rotep/scissorball/docs/images/render_left.png

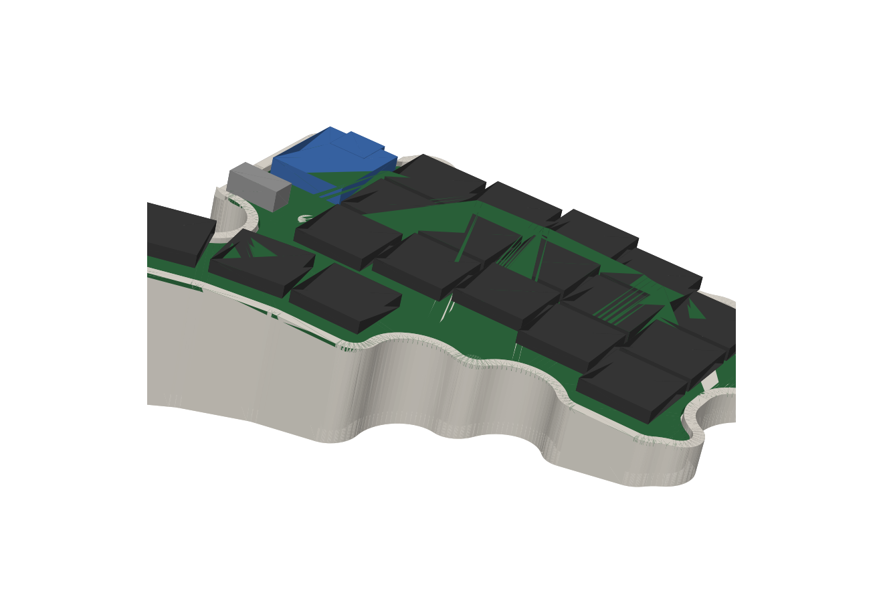
docs/images/render_left.png
