rotep/scissorball/docs/images/render_right.png

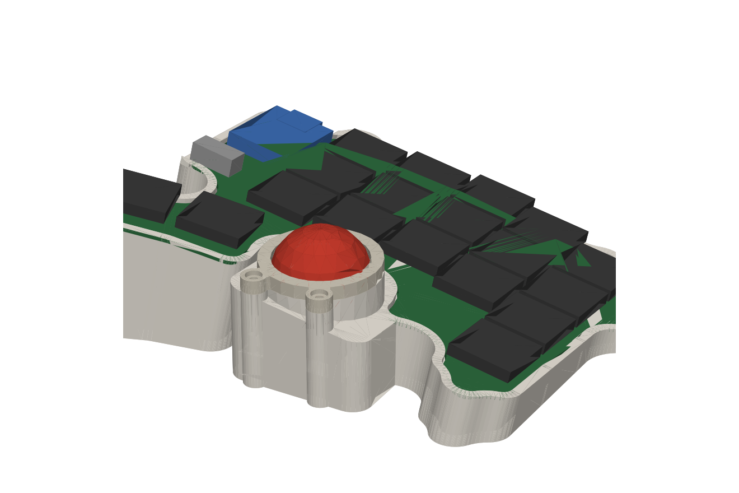
docs/images/render_right.png
