rotep/scissorball/docs/images/render_right_case_only.png

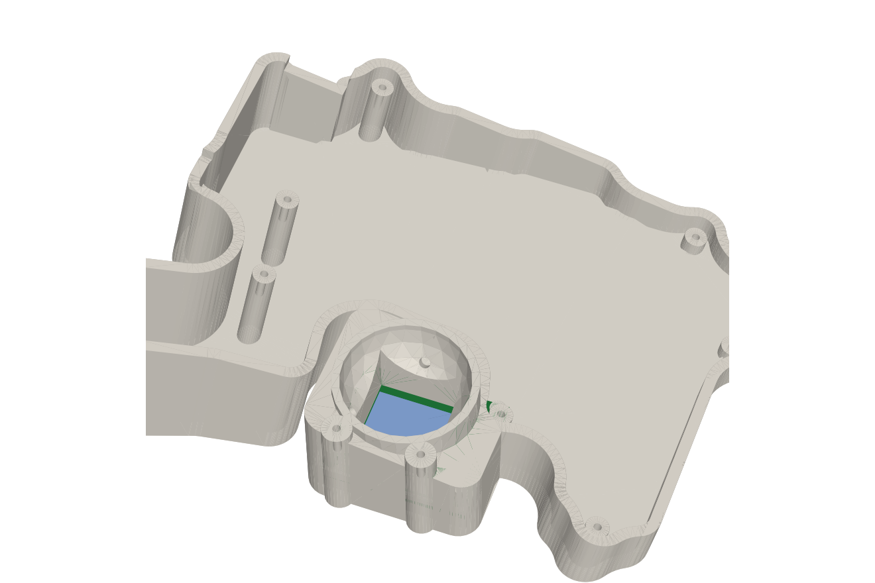
docs/images/render_right_case_only.png
