rotep/scissorball/hardware/case/scissorball_case_right.step

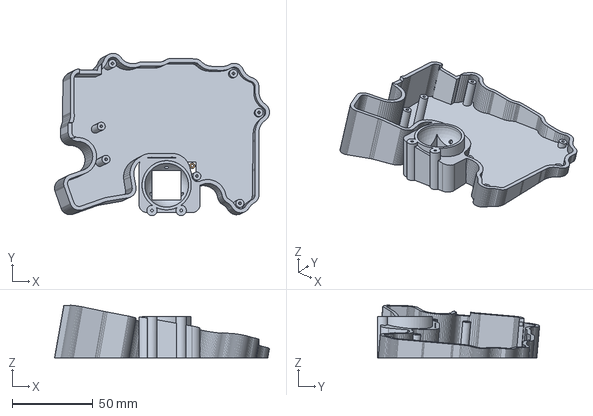
[picture p8: CAD file, 2026-09-30]
hardware/case/scissorball_case_right.step
132.9 x 100.3 x 32.5 mm
