rotep/scissorball/hardware/pcb/left/scissorball_left_pcb.step

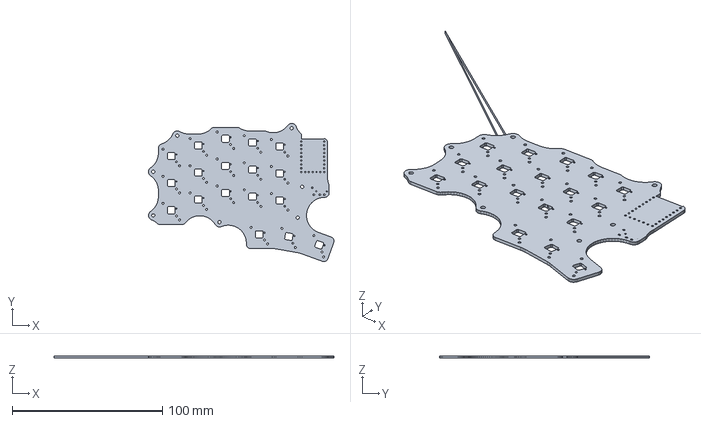
[picture p9: CAD file, 2026-09-30]
hardware/pcb/left/scissorball_left_pcb.step
186.2 x 139.7 x 1.51 mm
