rotep/scissorball/hardware/pcb/right/scissorball_right_pcb.step

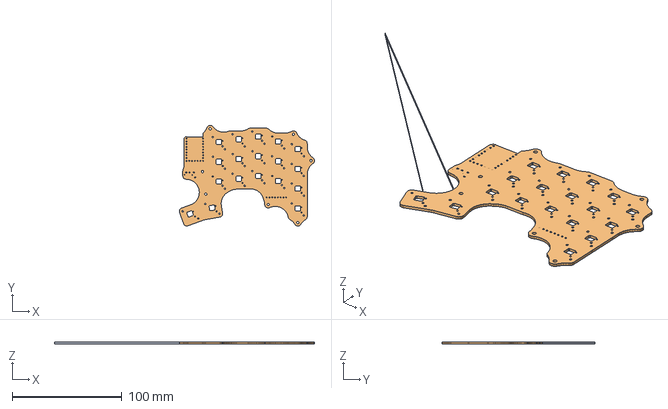
[picture p10: CAD file, 2026-09-30]
hardware/pcb/right/scissorball_right_pcb.step
237.2 x 139.7 x 1.51 mm
