rotep/scissorball/hardware/case/scissorball_case_left.step

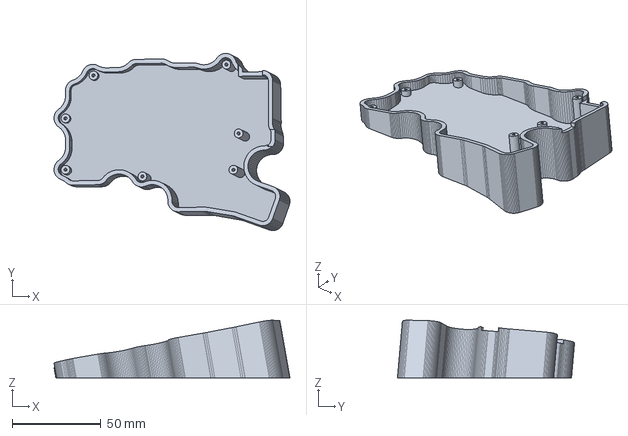
[picture p11: CAD file, 2026-09-30]
hardware/case/scissorball_case_left.step
132.9 x 99.7 x 32.5 mm
