rotep/scissorball/hardware/case/scissorball_ball_bezel.step

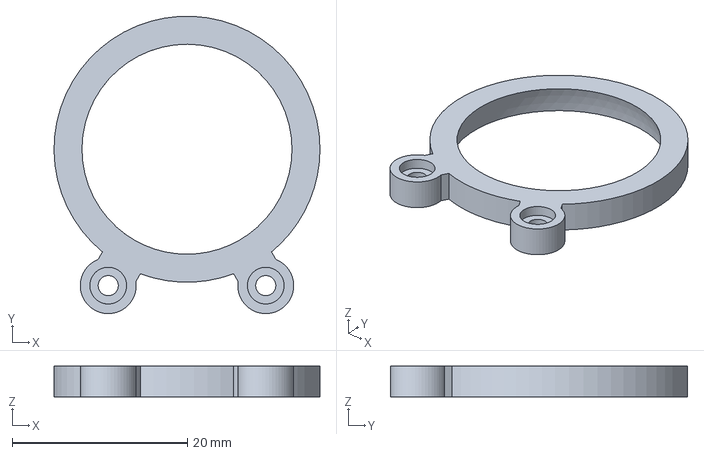
[picture p12: CAD file, 2026-09-30]
hardware/case/scissorball_ball_bezel.step
30.4 x 34.0 x 3.50 mm
