rotep/scissorball/(list of files, cad)

Other CAD files:
hardware/case/scissorball_ball_bezel.3mf
hardware/case/scissorball_ball_bezel.stl
hardware/case/scissorball_case_left.3mf
hardware/case/scissorball_case_left.stl
hardware/case/scissorball_case_right.3mf
hardware/case/scissorball_case_right.stl
