rotep/scissorball/docs/layout_1to1.pdf

ScissorBall 36 1:1 layout (A4 landscape, 100% / | )

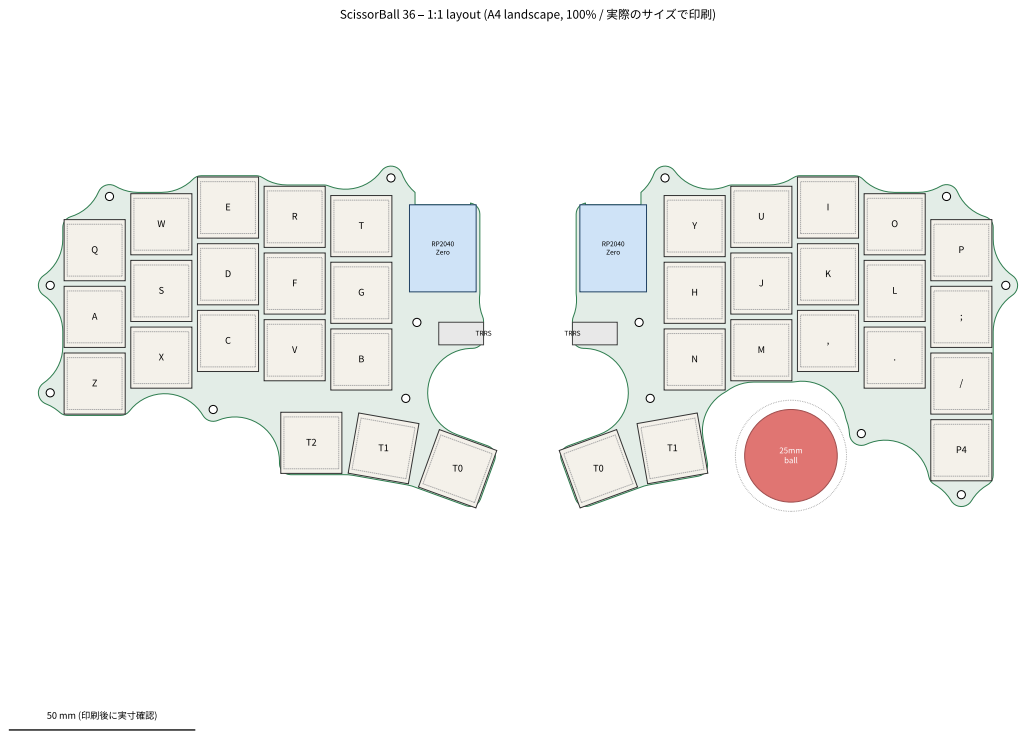
[picture p13: page 1]
RP2040 Zero; TRRS; ball
