rotep/scissorball/docs/pcb_left_1to1.pdf

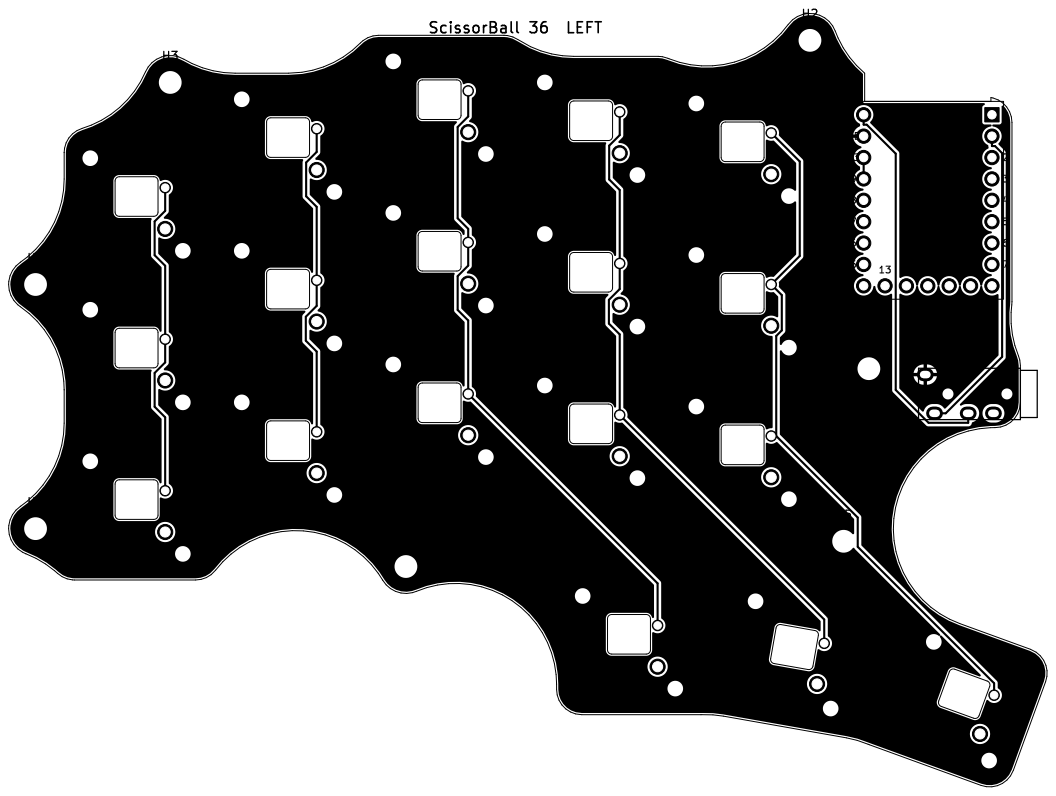
[picture p14: page 1]
