rotep/scissorball/docs/pcb_right_1to1.pdf

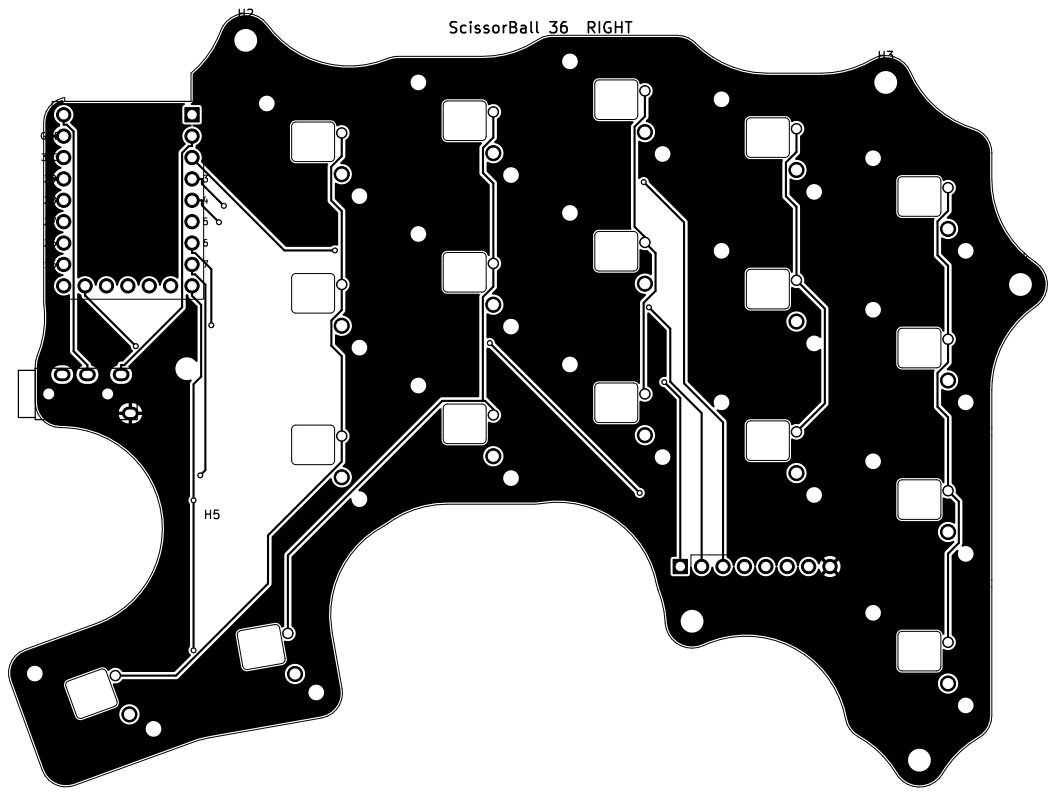
[picture p15: page 1]
