rotep/scissorball/hardware/pcb/right/scissorball_right.kicad_pcb

## KiCad design hardware/pcb/right/scissorball_right.kicad_pcb (2026-09-30)

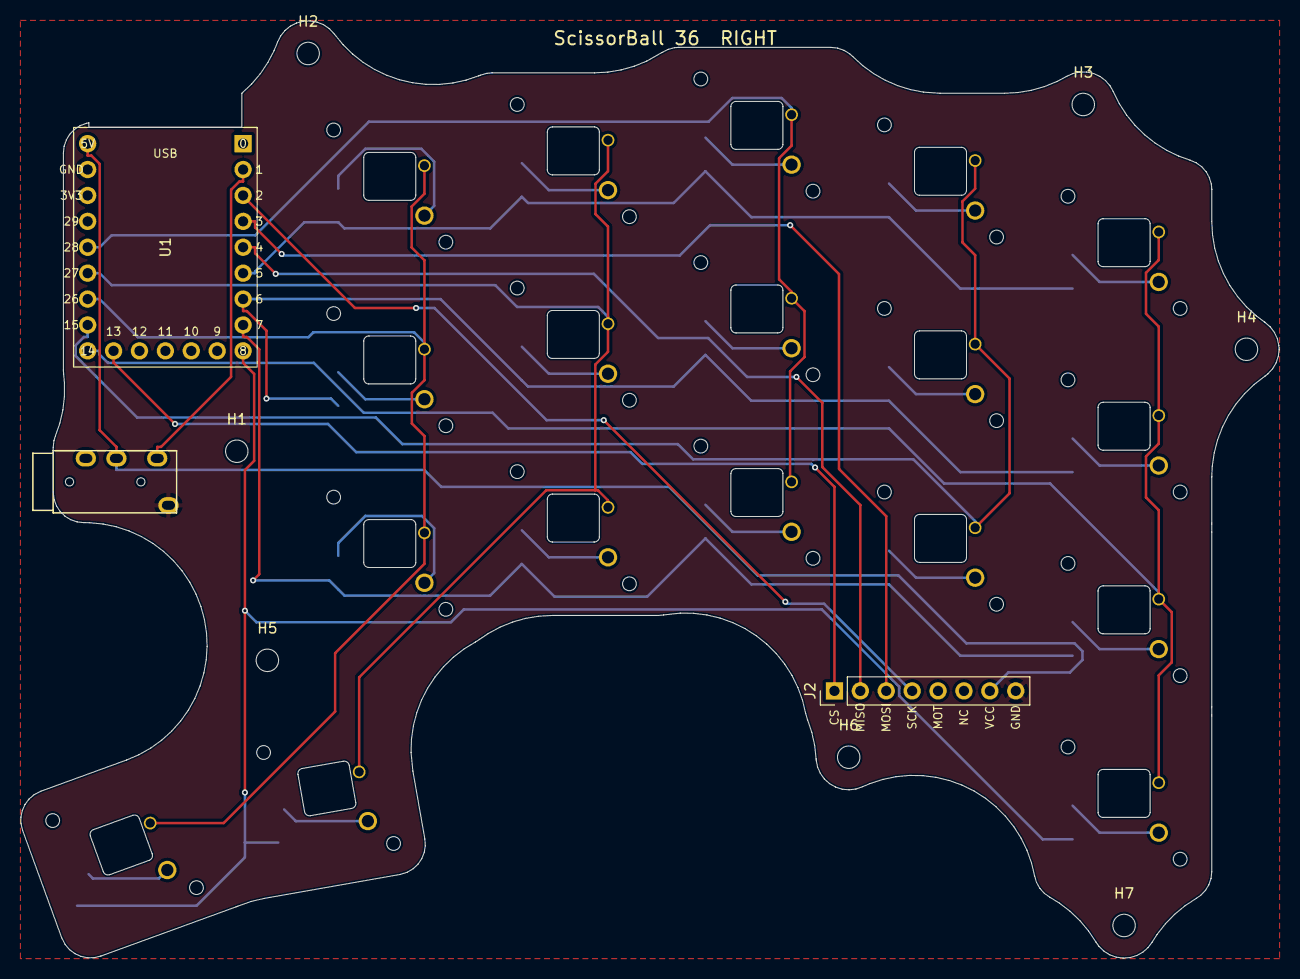
[picture p16: board scissorball_right.kicad_pcb from above]

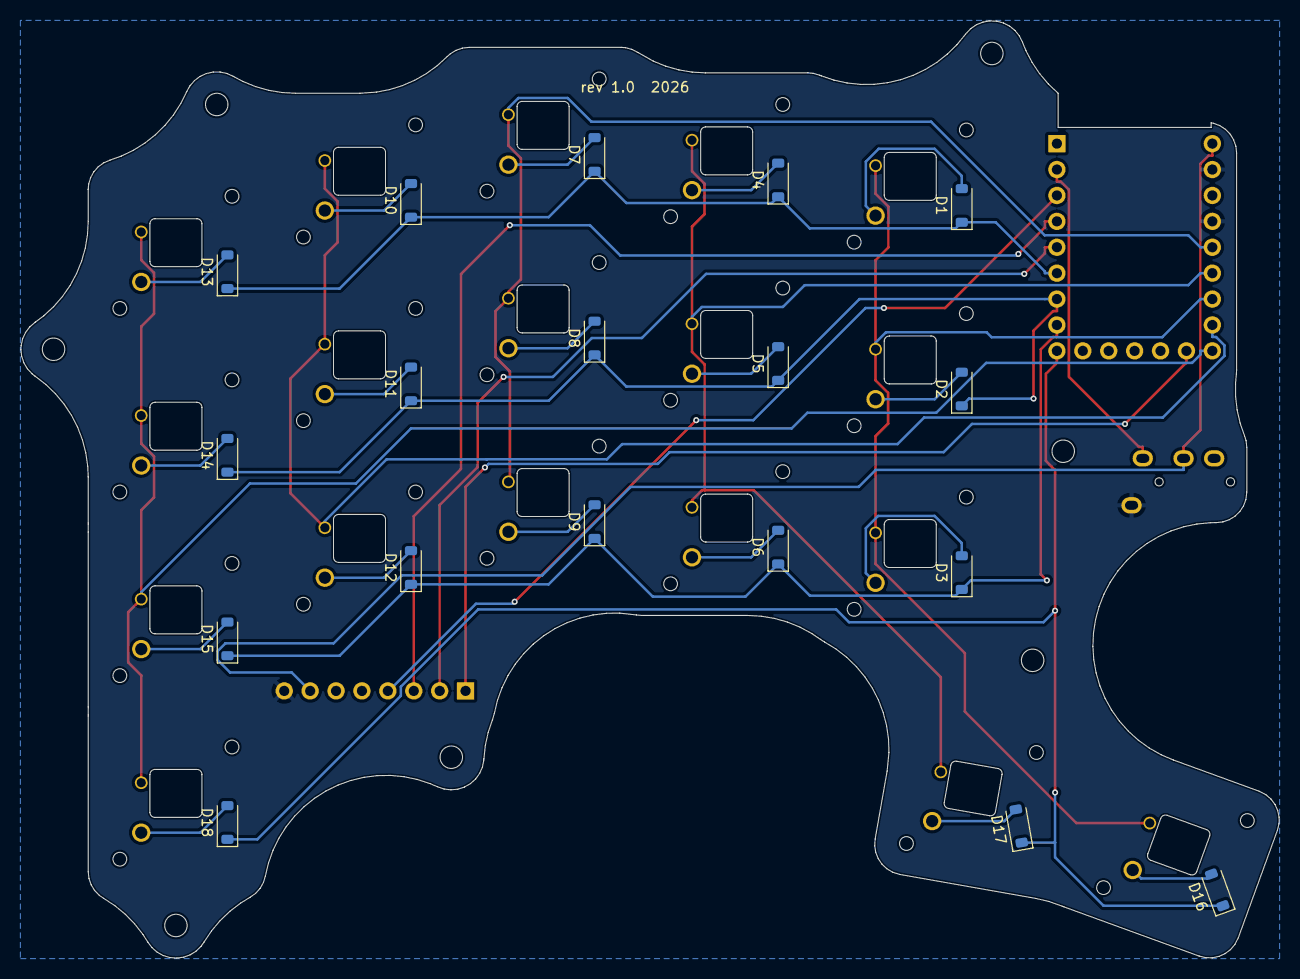
[picture p17: board scissorball_right.kicad_pcb from below]

Board: 2 copper layers, 123.4 x 91.9 mm, 46 parts (18 on the bottom side), 34 nets.

Parts:
D1, D2, D3, D4, D5, D6, D7, D8, D9, D10, D11, D12, D13, D14, D15, D16, D17, D18: 1N4148W; D_SOD-123
H1, H2, H3, H4, H5, H6, H7: MountingHole_2.2mm_M2
J1: PJ-320A; SB_TRRS_PJ-320A
J2: PMW3360 breakout; PinHeader_1x08_P2.54mm_Vertical
SW1: K00; SB_Kailh_PG1425
SW2: K10; SB_Kailh_PG1425
SW3: K20; SB_Kailh_PG1425
SW4: K01; SB_Kailh_PG1425
SW5: K11; SB_Kailh_PG1425
SW6: K21; SB_Kailh_PG1425
SW7: K02; SB_Kailh_PG1425
SW8: K12; SB_Kailh_PG1425
SW9: K22; SB_Kailh_PG1425
SW10: K03; SB_Kailh_PG1425
SW11: K13; SB_Kailh_PG1425
SW12: K23; SB_Kailh_PG1425
SW13: K04; SB_Kailh_PG1425
SW14: K14; SB_Kailh_PG1425
SW15: K24; SB_Kailh_PG1425
SW16: T0; SB_Kailh_PG1425
SW17: T1; SB_Kailh_PG1425
SW18: P4; SB_Kailh_PG1425
U1: RP2040-Zero; SB_RP2040_Zero

Connections:
COL0: SW1.1, SW2.1, SW3.1, SW16.1, U1.GP26
COL1: SW4.1, SW5.1, SW6.1, SW17.1, U1.GP27
COL2: SW7.1, SW8.1, SW9.1, U1.GP28
COL3: SW10.1, SW11.1, SW12.1, U1.GP15
COL4: SW13.1, SW14.1, SW15.1, SW18.1, U1.GP14
CS: J2.1, U1.GP13
D1: D1.2, SW1.2
D2: D2.2, SW2.2
D3: D3.2, SW3.2
D4: D4.2, SW4.2
D5: D5.2, SW5.2
D6: D6.2, SW6.2
D7: D7.2, SW7.2
D8: D8.2, SW8.2
D9: D9.2, SW9.2
D10: D10.2, SW10.2
D11: D11.2, SW11.2
D12: D12.2, SW12.2
D13: D13.2, SW13.2
D14: D14.2, SW14.2
D15: D15.2, SW15.2
D16: D16.2, SW16.2
D17: D17.2, SW17.2
D18: D18.2, SW18.2
DATA: J1.2, U1.GP1
GND: J1.1, J2.8, U1.GND, U1.GP29
MISO: J2.2, U1.GP4
MOSI: J2.3, U1.GP3
ROW0: D1.1, D4.1, D7.1, D10.1, D13.1, U1.GP5
ROW1: D2.1, D5.1, D8.1, D11.1, D14.1, U1.GP6
ROW2: D3.1, D6.1, D9.1, D12.1, D15.1, U1.GP7
ROW3: D16.1, D17.1, D18.1, U1.GP8
SCK: J2.4, U1.GP2
VBUS: J1.3, J2.7, U1.5V
